keelan-hough/SimpleAnalogueMicPre/Circuit Photos/Oscilloscope_Gainat9oClock.jpg

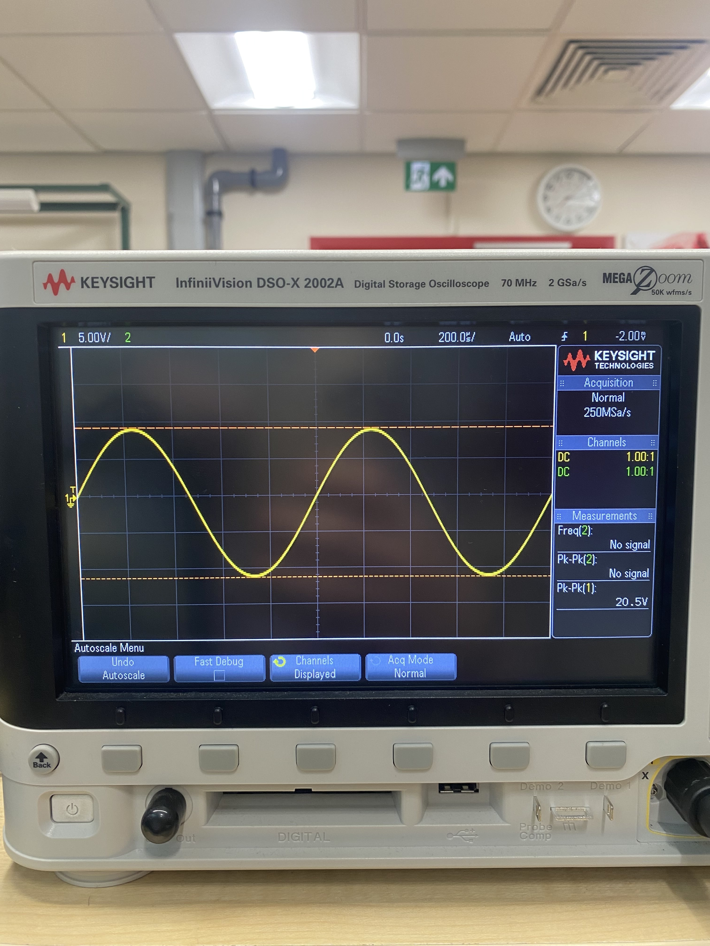
Circuit Photos/Oscilloscope_Gainat9oClock.jpg
