keelan-hough/SimpleAnalogueMicPre/Circuit Photos/Waveform Generator.jpg

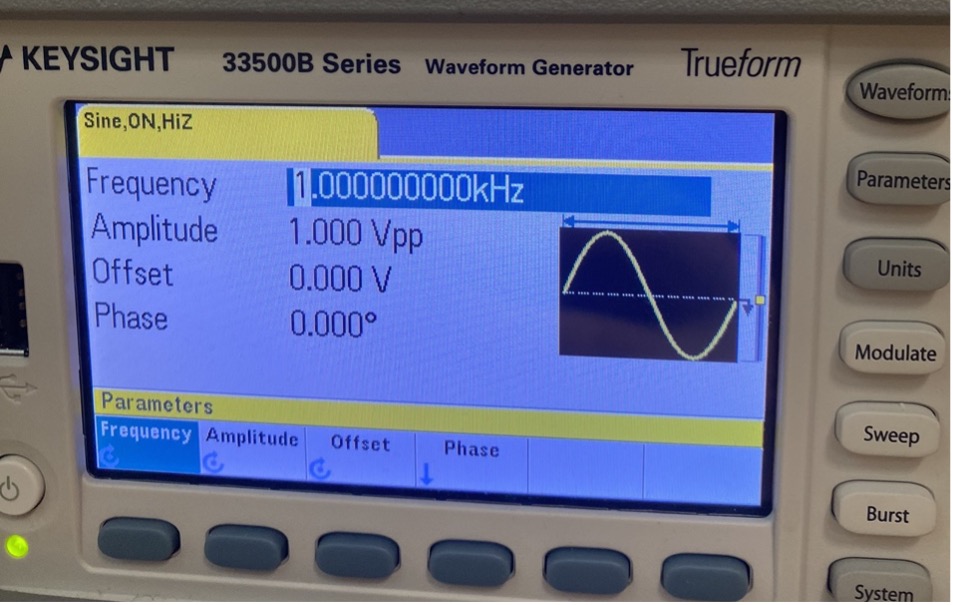
Circuit Photos/Waveform Generator.jpg
