keelan-hough/SimpleAnalogueMicPre/LTSpice Photos/80Hz High Pass FR.png

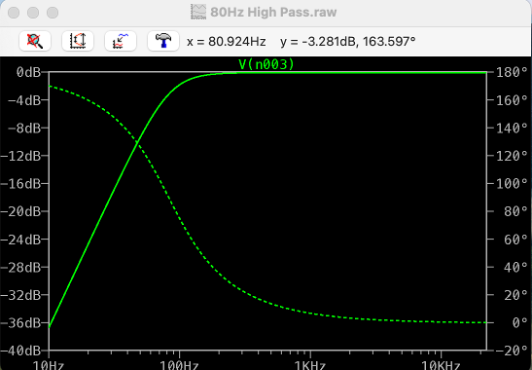
LTSpice Photos/80Hz High Pass FR.png
