keelan-hough/SimpleAnalogueMicPre/LTSpice Photos/80Hz High Pass LTSpice.png

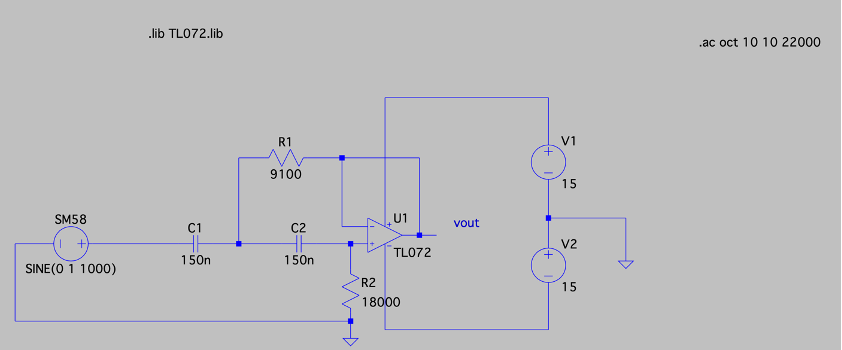
LTSpice Photos/80Hz High Pass LTSpice.png
