keelan-hough/SimpleAnalogueMicPre/LTSpice Photos/Bandpass Circuit.png

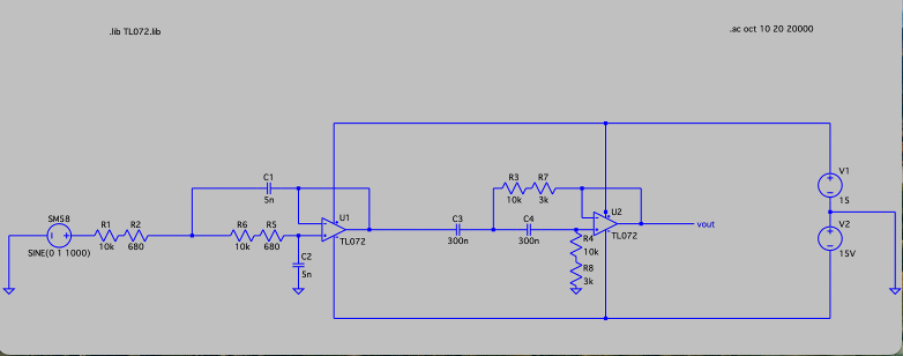
LTSpice Photos/Bandpass Circuit.png
