keelan-hough/SimpleAnalogueMicPre/LTSpice Photos/Bandpass FR.png

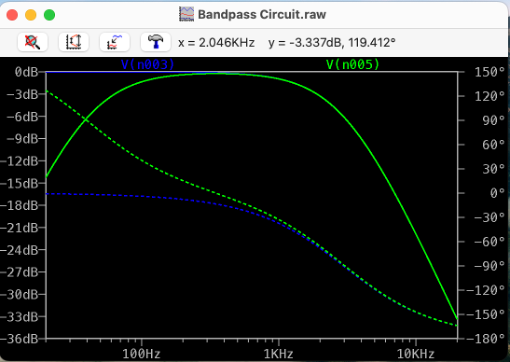
LTSpice Photos/Bandpass FR.png
