keelan-hough/SimpleAnalogueMicPre/LTSpice Photos/Gain Stage Output.png

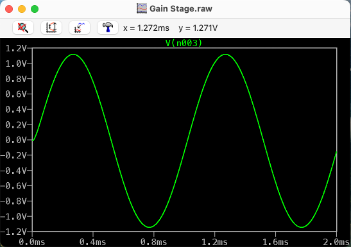
LTSpice Photos/Gain Stage Output.png
