keelan-hough/SimpleAnalogueMicPre/LTSpice Photos/Gain Stage.png

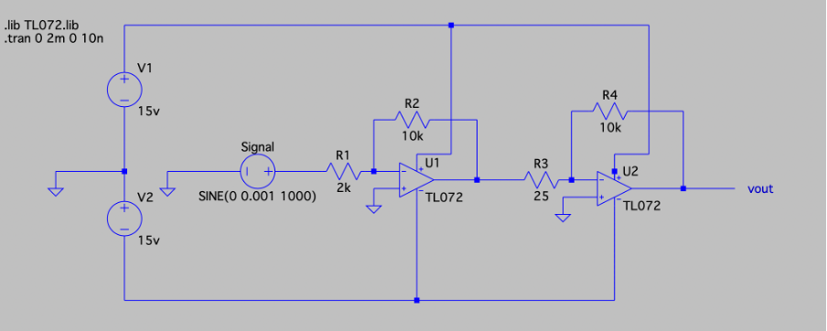
LTSpice Photos/Gain Stage.png
