keelan-hough/SimpleAnalogueMicPre/LTSpice Files/80Hz High Pass.asc

C1: Cap; 150n
C2: Cap; 150n
R1: Res; 9100
R2: Res; 18000
SM58: Voltage; SINE(0 1 1000); AC 1; Rser=180
U1: opamp2; TL072
V1: Voltage; 15
V2: Voltage; 15
Named nets: 0
.ac oct 10 10 22000
.lib TL072.lib
vout
