keelan-hough/SimpleAnalogueMicPre/LTSpice Files/Bandpass Circuit.asc

C1: Cap; 5n
C2: Cap; 5n
C3: Cap; 300n
C4: Cap; 300n
R1: Res; 10k
R2: Res; 680
R3: Res; 10k
R4: Res; 10k
R5: Res; 680
R6: Res; 10k
R7: Res; 3k
R8: Res; 3k
SM58: Voltage; SINE(0 1 1000); AC 1; Rser=150
U1: opamp2; TL072
U2: opamp2; TL072
V1: Voltage; 15
V2: Voltage; 15V
Named nets: 0
.lib TL072.lib
vout
.ac oct 10 20 20000
