keelan-hough/SimpleAnalogueMicPre/LTSpice Files/Gain Stage.asc

R1: Res; 2k
R2: Res; 10k
R3: Res; 25
R4: Res; 10k
Signal: Voltage; SINE(0 0.001 1000); Rser=1500
U1: opamp2; TL072
U2: opamp2; TL072
V1: Voltage; 15v
V2: Voltage; 15v
Named nets: 0
.lib TL072.lib
.tran 0 2m 0 10n
vout
